ONAN0/Mecanum/mecanum.png

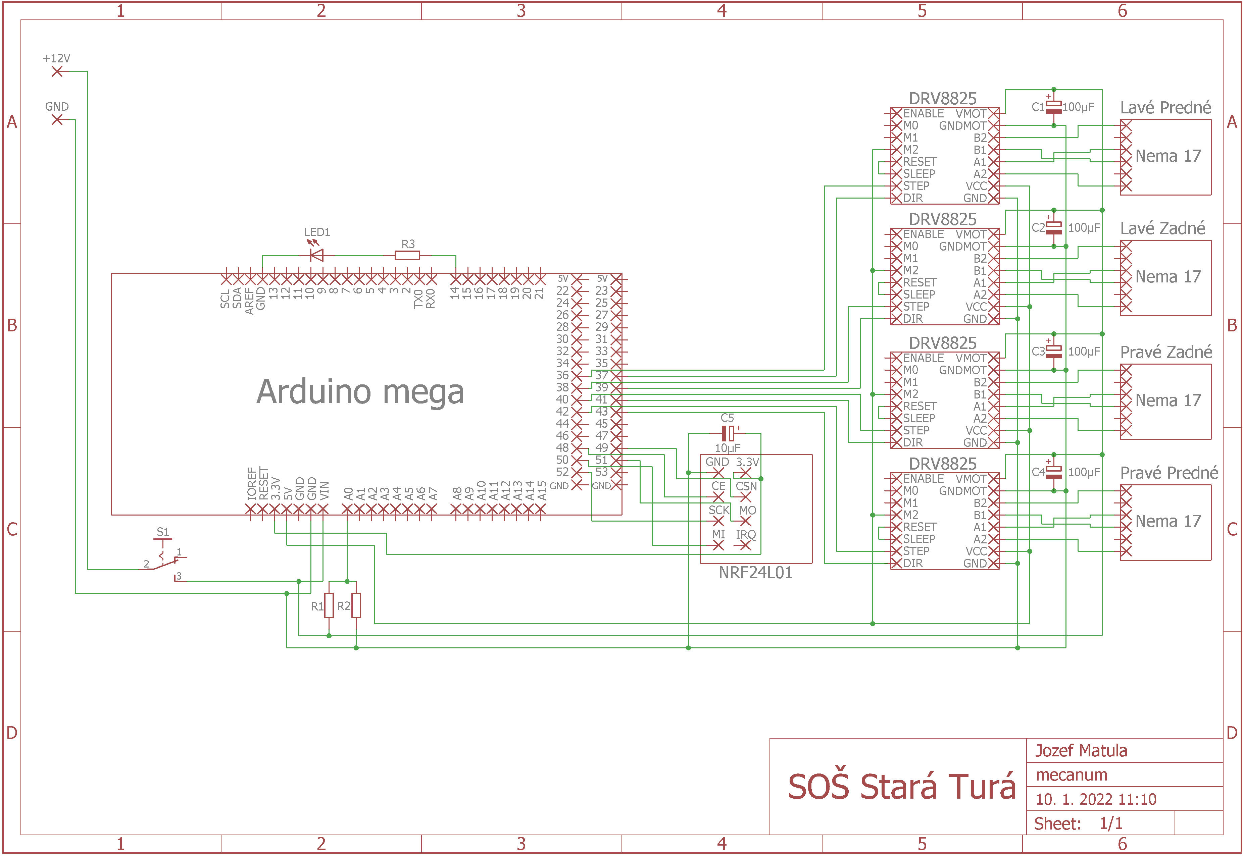
mecanum.png
