ONAN0/Mecanum/ovladac.png

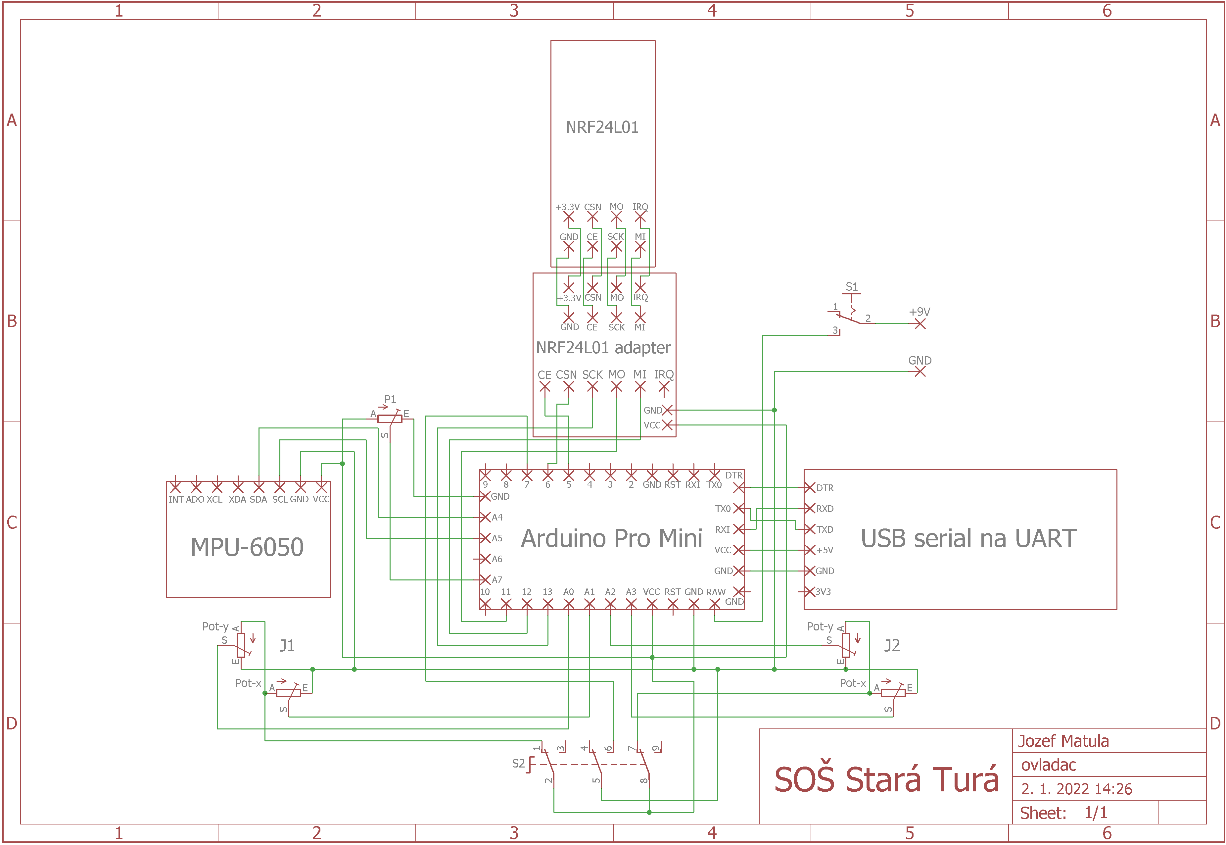
ovladac.png
